orangewaylab/CitizenSensor/README.md

# CitizenSensor
A low budget battery powered LoRa node to smart up your city

<p align="center">
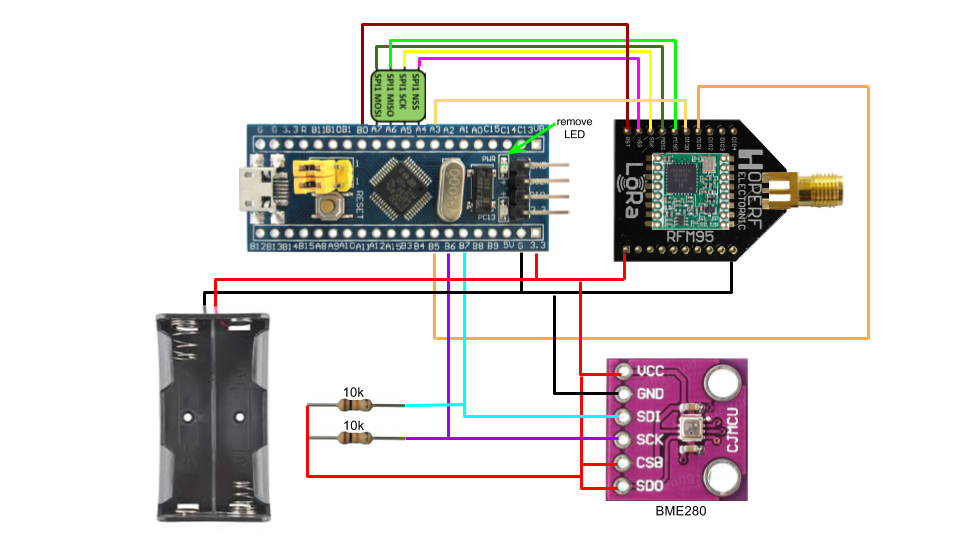
[picture p1: media/STM32LoraNode.png]
LoraNode Fritzing
    
</p>

## bill of materials
| Parts List for boxed version              |
|-------------------------------------------|
| STM32F103C8T6 Minimum System Dev Board (blue pill)   |
| RFM95 868Mhz Modul                        |
| SMA PCB Connector female                  |
| Antenna SMA male 868mhz 2dbi              |
| BME 280 Breakout 6pin 3.3v only w/ pullup |
| Battery Holder 2xAA                       |
| Header 2.54mm 12pin                       |
| Abzweigdose IP54 grau Aufputz 75x75x40 mm |
| CitizenSensor V4.0 PCB                    |
CS40-Tisch600.jpg
## Prototyp 
<p align="center">
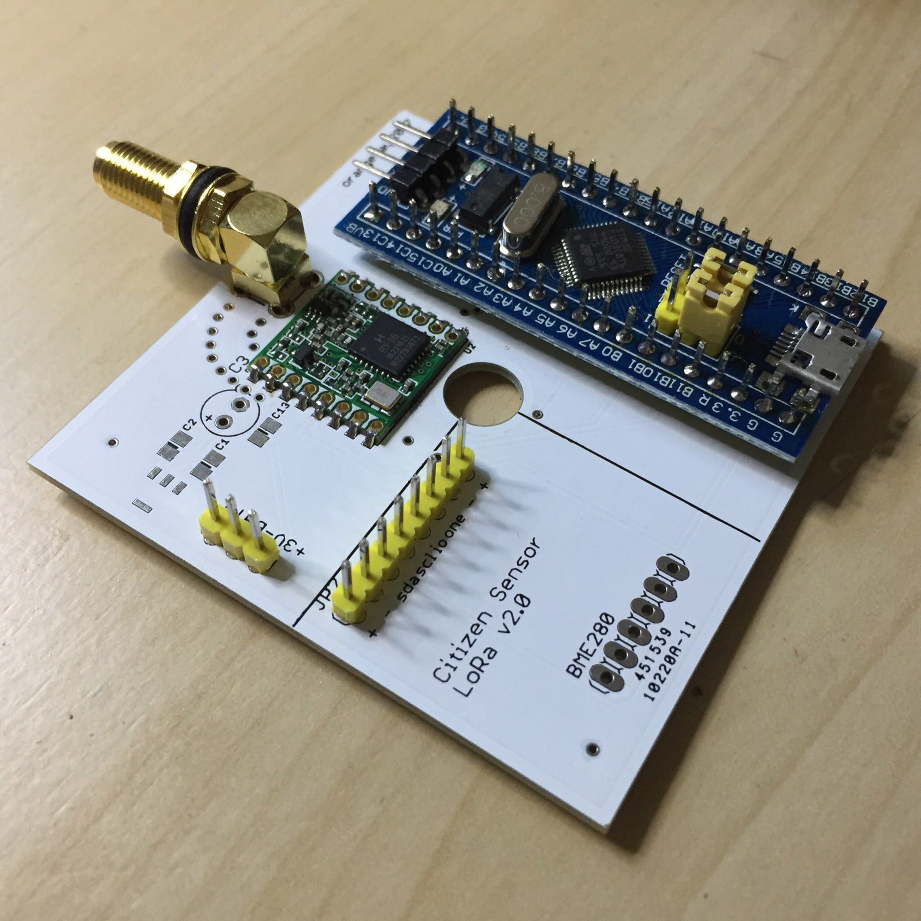
[picture p2: media/CitizenSensorLora20.jpg]
Prototype
    
</p>

## Citizen Sensor Kit (PCB 4.0)
<p align="center">
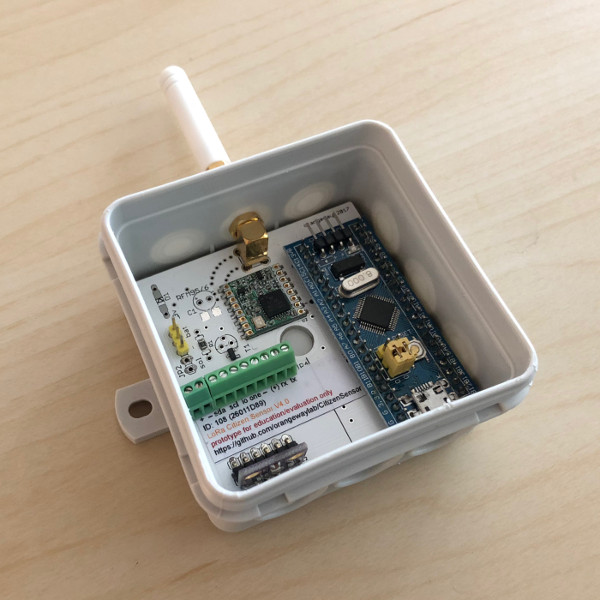
[picture p3: media/CS40-Tisch600.jpg]
Kit
    
</p>

## Schematic PCB V4.0
<p align="center">
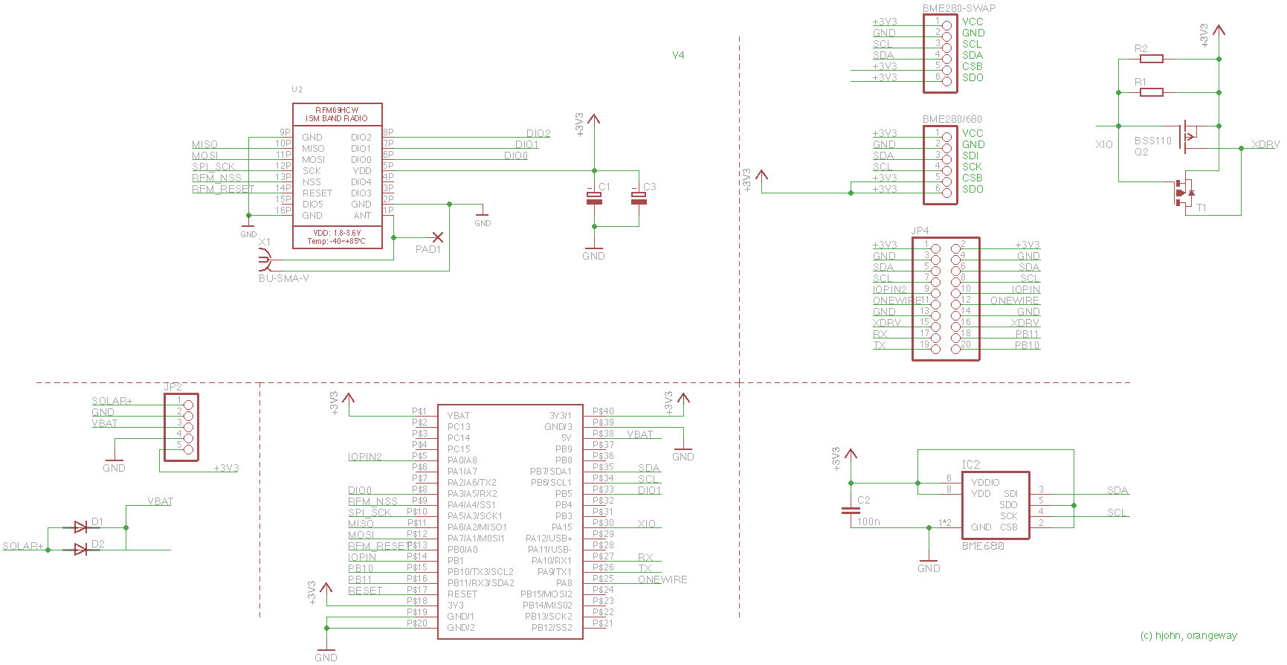
[picture p4: media/CitizenSensor-LoRa-STM32-v4-01-BME680.png]
Schematic
    
</p>

## PCB V4.0 top
<p align="center">
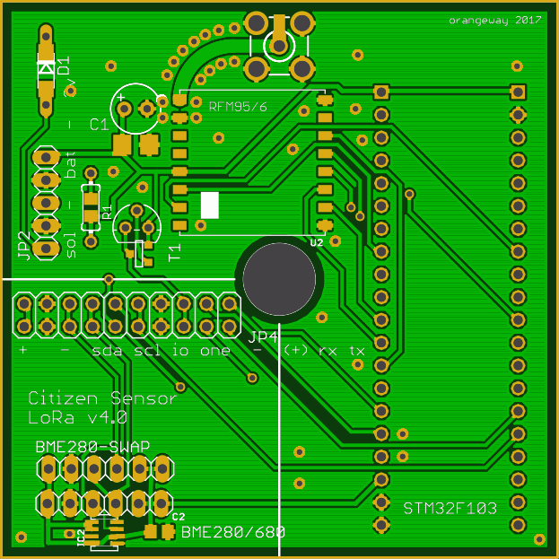
[picture p5: media/pcb40.png]
pcb
    
</p>
