orangewaylab/CitizenSensor/(threads)

Thread 1 (2017-05-19):

'struct lmic_t' has no member named 'skipRX'

SunCobalt, 2017-05-19:
The original library from [IBM](http://www.research.ibm.com/labs/zurich/ics/lrsc/lmic.html) well as the standard library in the Arduino IDE do not contain skipRX as used in line 623 in the [Sketch](https://github.com/orangewaylab/CitizenSensor/blob/master/CitizenSensor-STM32/CitizenSensor-STM32.ino#L623)

```
struct lmic_t {
    // Radio settings TX/RX (also accessed by HAL)
    ostime_t    txend;
    ostime_t    rxtime;
    u4_t        freq;
    s1_t        rssi;
    s1_t        snr;
    rps_t       rps;
    u1_t        rxsyms;
    u1_t        dndr;
    s1_t        txpow;     // dBm

    osjob_t     osjob;

    // Channel scheduling
#if defined(CFG_eu868)
    band_t      bands[MAX_BANDS];
    u4_t        channelFreq[MAX_CHANNELS];
    u2_t        channelDrMap[MAX_CHANNELS];
    u2_t        channelMap;
#elif defined(CFG_us915)
    u4_t        xchFreq[MAX_XCHANNELS];    // extra channel frequencies (if device is behind a repeater)
    u2_t        xchDrMap[MAX_XCHANNELS];   // extra channel datarate ranges  ---XXX: ditto
    u2_t        channelMap[(72+MAX_XCHANNELS+15)/16];  // enabled bits
    u2_t        chRnd;        // channel randomizer
#endif
    u1_t        txChnl;          // channel for next TX
    u1_t        globalDutyRate;  // max rate: 1/2^k
    ostime_t    globalDutyAvail; // time device can send again

    u4_t        netid;        // current network id (~0 - none)
    u2_t        opmode;
    u1_t        upRepeat;     // configured up repeat
    s1_t        adrTxPow;     // ADR adjusted TX power
    u1_t        datarate;     // current data rate
    u1_t        errcr;        // error coding rate (used for TX only)
    u1_t        rejoinCnt;    // adjustment for rejoin datarate
    s2_t        drift;        // last measured drift
    s2_t        lastDriftDiff;
    s2_t        maxDriftDiff;

    u1_t        pendTxPort;
    u1_t        pendTxConf;   // confirmed data
    u1_t        pendTxLen;    // +0x80 = confirmed
    u1_t        pendTxData[MAX_LEN_PAYLOAD];

    u2_t        devNonce;     // last generated nonce
    u1_t        nwkKey[16];   // network session key
    u1_t        artKey[16];   // application router session key
    devaddr_t   devaddr;
    u4_t        seqnoDn;      // device level down stream seqno
    u4_t        seqnoUp;

    u1_t        dnConf;       // dn frame confirm pending: LORA::FCT_ACK or 0
    s1_t        adrAckReq;    // counter until we reset data rate (0=off)
    u1_t        adrChanged;

    u1_t        margin;
    bit_t       ladrAns;      // link adr adapt answer pending
    bit_t       devsAns;      // device status answer pending
    u1_t        adrEnabled;
    u1_t        moreData;     // NWK has more data pending
    bit_t       dutyCapAns;   // have to ACK duty cycle settings
    u1_t        snchAns;      // answer set new channel
    // 2nd RX window (after up stream)
    u1_t        dn2Dr;
    u4_t        dn2Freq;
    u1_t        dn2Ans;       // 0=no answer pend, 0x80+ACKs

    // Class B state
    u1_t        missedBcns;   // unable to track last N beacons
    u1_t        bcninfoTries; // how often to try (scan mode only)
    u1_t        pingSetAns;   // answer set cmd and ACK bits
    rxsched_t   ping;         // pingable setup

    // Public part of MAC state
    u1_t        txCnt;
    u1_t        txrxFlags;  // transaction flags (TX-RX combo)
    u1_t        dataBeg;    // 0 or start of data (dataBeg-1 is port)
    u1_t        dataLen;    // 0 no data or zero length data, >0 byte count of data
    u1_t        frame[MAX_LEN_FRAME];

    u1_t        bcnChnl;
    u1_t        bcnRxsyms;    //
    ostime_t    bcnRxtime;
    bcninfo_t   bcninfo;      // Last received beacon info

    u1_t        noRXIQinversion;
};
```

orangewaylab, 2017-06-01:
The code use a sligthly adapted lmic version which saves cpu time: https://github.com/tomtor/arduino-lmic/commit/8feb4f6cbe5a719ea6e7939e848c0b32a7df30e8. If not required in your case, just comment out the lines. Otherwise use the adapted library https://github.com/tomtor/arduino-lmic/.

Closed 2017-06-01.

Thread 3 (2017-10-01):

Hardware Design Files?

tiefpunkt, 2017-10-01:
Hey!

Really like this concept. We're trying to reboot the TTN&LoRaWAN initiative over here in Munich, and I'm currently looking at a few different options for easy to build sensor boards. I'd like to give this one a try, but can't find a way to get the boards. Do you have the design files to share in here as well? Or do you have a few spare boards? Or ideally both? ;)

Thanks :)

tiefpunkt, 2017-11-07:
Hi @orangewaylab,
would you happen to have time to upload the design files, or even some boards to spare? That would be great.
Thanks,
Severin

Nordrunner01, 2018-03-18:
Moinsen.

Jo wäre(n) ich/wir auch daran interessiert die Platinen nachzubauen. Tolles Konzept!

Wie wäre es, wenn ihr die Platinen bei [pcbs.io](https://pcbs.iol) teilt ( https://pcbs.io/search )?

Gruß
