orangewaylab/CitizenSensor/(commit log)

2017-05-17 fixed dio1 wiring
2017-05-25 added wiring
2017-06-01 prototype picture
2017-07-12 pcb 4.0 + pics
